bristol-seds/pressure/README.md

## BLE Pressure Sensor

Under development
