bristol-seds/pressure/hardware/Parts.md

# Parts List

---

## Actives

| Part | Description | Farnell # | Quantity Required | Notes
| ---  | --- | --- | --- | ---
|BMP180|Board Mount Pressure Sensors Digital Barometer 12uA, 300-1200hPa|[262-BMP180](http://uk.mouser.com/Search/Refine.aspx?N=1323043&Keyword=262-BMP180)|1|Pressure Sensor
|nRF51822-QFAA-R7|RF System on a Chip - SoC 2.4GHz BT low Energy 256KB Flash 16KB Ram|[949-NRF51822-QFAA-R7](http://uk.mouser.com/Search/Refine.aspx?N=1323043&Keyword=949-NRF51822-QFAA-R7)|1|IC3
|TLV70033DCKT|TEXAS INSTRUMENTS - IC, LDO, 200MA, 3.3V, 5SC70|[1815750](http://uk.farnell.com/webapp/wcs/stores/servlet/Search?st=1815750) [595-TLV70033DCKT](http://uk.mouser.com/Search/Refine.aspx?N=1323043&Keyword=595-TLV70033DCKT)|1|IC4 DCK package = SC70
|MAX1555EZK+T.|MAXIM INTEGRATED PRODUCTS - CHARGER, BATT, LI+, USB/AC, 5SOT23|[1628222](http://uk.farnell.com/webapp/wcs/stores/servlet/Search?st=1628222) [700-MAX1555EZK+T](http://uk.mouser.com/Search/Refine.aspx?N=1323043&Keyword=700-MAX1555EZK+T)|1|IC5
|8Z-16.000MAAJ-T|TXC - XTAL, 16.000MHZ, 18PF, SMD, 2.5X2.0|[1842186](http://uk.farnell.com/webapp/wcs/stores/servlet/Search?st=1842186) [717-8Z-16.000MAAJ-T](http://uk.mouser.com/Search/Refine.aspx?N=1323043&Keyword=717-8Z-16.000MAAJ-T)|1|Y1 Xtal

## Passives

| Part | Description | Farnell # | Quantity Required | Notes
| ---  | --- | --- | --- | ---
|CRG0402F1K0|TE CONNECTIVITY - RESISTOR, FIXED, 1K0, 1%, 0402|[2331474](http://uk.farnell.com/webapp/wcs/stores/servlet/Search?st=2331474)|4|R1 R2 R3 R4 LEDs, pull
|MCFT000004|MULTICOMP - INDUCTOR, 0402, 4.7NH|[1711709](http://uk.farnell.com/webapp/wcs/stores/servlet/Search?st=1711709)|1|L1
|MCFT000007|MULTICOMP - INDUCTOR, 0402, 10NH|[1711712](http://uk.farnell.com/webapp/wcs/stores/servlet/Search?st=1711712)|1|L2
|MCFT000003|MULTICOMP - INDUCTOR, 0402, 3.3NH|[1711708](http://uk.farnell.com/webapp/wcs/stores/servlet/Search?st=1711708)|1|L3
|MLZ1608M100WT|TDK - INDUCTOR, SHIELDED, 10UH, 20%|[2215635](http://uk.farnell.com/webapp/wcs/stores/servlet/Search?st=2215635)|1|L4 10µH
|MCFT000008|MULTICOMP - INDUCTOR, 0402, 15NH|[1711713](http://uk.farnell.com/webapp/wcs/stores/servlet/Search?st=1711713)|1|L5
|GRM155R71A473KA01D|MURATA - CAPACITOR, MLCC, X7R, 0.047UF, 10V, 0402|[2456103](http://uk.farnell.com/webapp/wcs/stores/servlet/Search?st=2456103)|1|C1
|MC0402X104K100CT|MULTICOMP - CAP, MLCC, X5R, 100NF, 10V, 0402|[1759380](http://uk.farnell.com/webapp/wcs/stores/servlet/Search?st=1759380)|3|C2 C10 C13
|MC0402B222J500CT|MULTICOMP - CAP, MLCC, X7R, 2.2NF, 50V, 0402|[2320767](http://uk.farnell.com/webapp/wcs/stores/servlet/Search?st=2320767)|1|C3
|GRM1555C1H1R0CA01D|MURATA - CAP, MLCC, C0G/NP0, 1PF, 50V, 0402|[2218842](http://uk.farnell.com/webapp/wcs/stores/servlet/Search?st=2218842)|1|C4
|GRM1555C1H2R2CA01D|MURATA - CAP, MLCC, C0G, 2.2PF, 50V, 0402|[2434609](http://uk.farnell.com/webapp/wcs/stores/servlet/Search?st=2434609)|1|C5
|GRM1555C1H1R5CA01D|MURATA - CAP, MLCC, C0G/NP0, 1.5PF, 50V, 0402|[1828869](http://uk.farnell.com/webapp/wcs/stores/servlet/Search?st=1828869)|2|C6 C7
|MC0402X105K6R3CT|MULTICOMP - CAP, MLCC, X5R, 1UF, 6.3V, 0402|[1759375](http://uk.farnell.com/webapp/wcs/stores/servlet/Search?st=1759375)|1|C8
|GRM155R60J475ME87D|MURATA - CAP, MLCC, X5R, 4.7UF, 6.3V, 0402|[2362092](http://uk.farnell.com/webapp/wcs/stores/servlet/Search?st=2362092)|1|C9
|MC0402N120J500CT|MULTICOMP - CAP, MLCC, C0G/NP0, 12PF, 50V, 0402|[1758943](http://uk.farnell.com/webapp/wcs/stores/servlet/Search?st=1758943)|2|C11 C12
|MC0603X105M6R3CT|MULTICOMP - CAP, MLCC, X5R, 1UF, 6.3V, 0603|[2309013](http://uk.farnell.com/webapp/wcs/stores/servlet/Search?st=2309013)|3|C14 C15 C16

## Misc

| Part | Description | Farnell # | Quantity Required | Notes
| ---  | --- | --- | --- | ---
|20021121-00010C4LF|FCI - CONNECTOR, HEADER, SMT, R/A, 1.27MM, 10P|[1865279](http://uk.farnell.com/webapp/wcs/stores/servlet/Search?st=1865279) [649-202112100010C4LF](http://uk.mouser.com/Search/Refine.aspx?N=1323043&Keyword=649-202112100010C4LF)|1|JTAG1
|USB3065-30-00-A|GLOBAL CONNECTOR TECHNOLOGY - CONN, USB 2.0 MICRO B, RCPT, 5POS, SMT|[2443111](http://uk.farnell.com/webapp/wcs/stores/servlet/Search?st=2443111)|1|X1 µUSB
