bristol-seds/pressure/hardware/pressure.brd

## EAGLE design hardware/pressure.brd (2015-03-13)

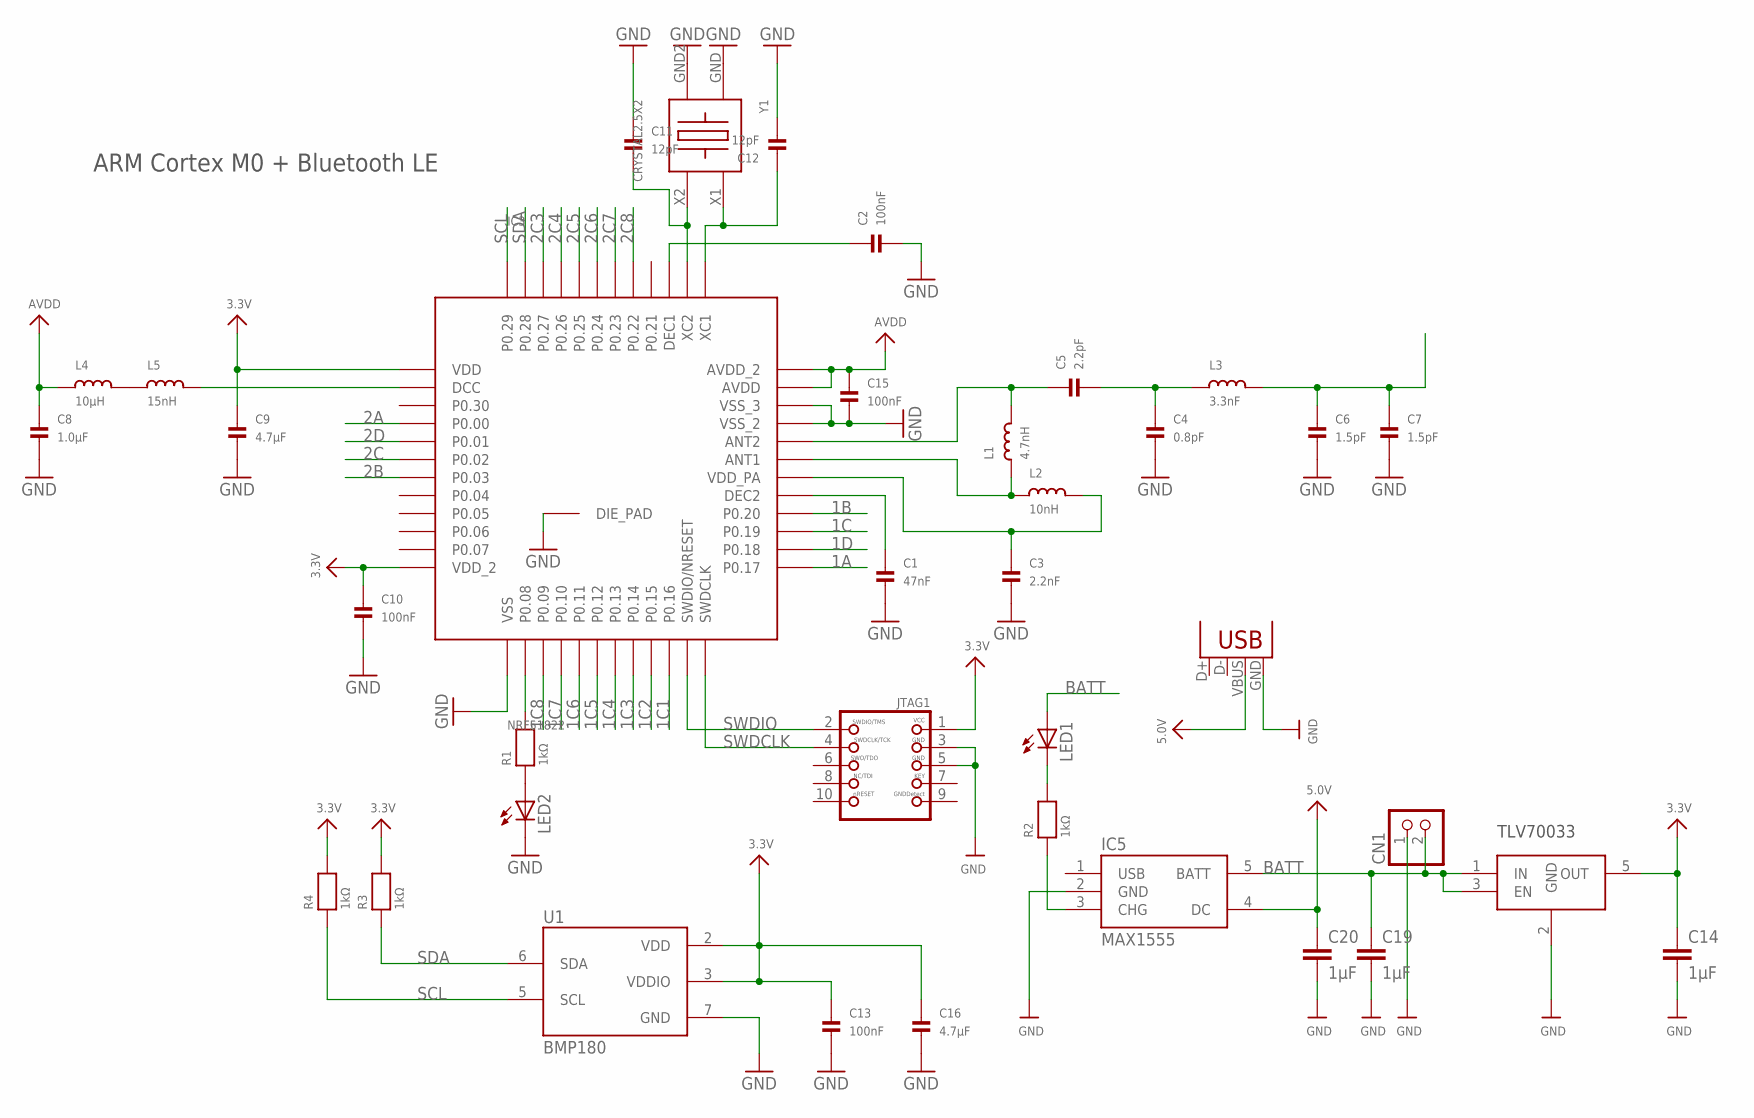
[picture p1: schematic pressure.sch]

Parts:
C1: 47nF; _0402
C2, C10, C13, C15: 100nF; _0402
C3: 2.2nF; _0402
C4: 0.8pF; _0402
C5: 2.2pF; _0402
C6, C7: 1.5pF; _0402
C8: 1.0µF; _0402
C9, C16: 4.7µF; _0402
C11, C12: 12pF; _0402
C14, C19, C20: 1µF; C0603K
CN1: JST_2PIN; JSTPH2
IC3: NRF51822; QFN48
IC4: TLV70033DCK; SC70-5L
IC5: MAX1555; SOT23-5
JTAG1: JTAG-CORTEXM3SMT; 2X05_1.27MM_SMT
L1: 4.7nH; _0402
L2: 10nH; _0402
L3: 3.3nF; _0402
L4: 10µH; _0402
L5: 15nH; _0402
LED1, LED2: LEDCHIPLED_0603; CHIPLED_0603
R1, R2, R3, R4: 1kΩ; _0402
U1: BMP180
X1: USB-MICROB
Y1: CRYSTAL2.5X2; 2.5X2MM

Connections:
1A: IC3.25 (P0.17)
1B: IC3.28 (P0.20)
1C: IC3.27 (P0.19)
1C1: IC3.22 (P0.16)
1C2: IC3.21 (P0.15)
1C3: IC3.20 (P0.14)
1C4: IC3.19 (P0.13)
1C5: IC3.18 (P0.12)
1C6: IC3.17 (P0.11)
1C7: IC3.16 (P0.10)
1C8: IC3.15 (P0.09)
1D: IC3.26 (P0.18)
2A: IC3.4 (P0.00)
2B: IC3.7 (P0.03)
2C: IC3.6 (P0.02)
2C3: IC3.46 (P0.27)
2C4: IC3.45 (P0.26)
2C5: IC3.44 (P0.25)
2C6: IC3.43 (P0.24)
2C7: IC3.42 (P0.23)
2C8: IC3.41 (P0.22)
2D: IC3.5 (P0.01)
3.3V: C9.1, C10.1, C13.1, C14.1, C16.1, IC3.1 (VDD), IC3.12 (VDD_2), IC4.5 (OUT), JTAG1.1, R3.2, R4.2, U1.2 (VDD), U1.3 (VDDIO)
5.0V: C20.1, IC5.4 (DC), X1.VBUS
ANT: C6.1, C7.1, L3.2
ANT1: IC3.31 (ANT1), L1.1, L2.1
ANT2: C5.1, IC3.32 (ANT2), L1.2
AVDD: C8.1, C15.1, IC3.35 (AVDD), IC3.36 (AVDD_2), L4.1
BATT: C19.1, CN1.2, IC4.1 (IN), IC4.3 (EN), IC5.5 (BATT), LED1.A
CHG: IC5.3 (CHG), R2.1
DCC: IC3.2 (DCC), L5.2
DEC1: C2.1, IC3.39 (DEC1)
DEC2: C1.1, IC3.29 (DEC2)
GND: C1.2, C2.2, C3.2, C4.2, C6.2, C7.2, C8.2, C9.2, C10.2, C11.1, C12.2, C13.2, C14.2, C15.2, C16.2, C19.2, C20.2, CN1.1, IC3.13 (VSS), IC3.33 (VSS_2), IC3.34 (VSS_3), IC3.GND (DIE_PAD), IC4.2 (GND), IC5.2 (GND), JTAG1.3, JTAG1.5, LED2.C, U1.7 (GND), X1.GND, Y1.GND, Y1.GND2
LED: LED1.C, R2.2
unnamed: L4.2, L5.1
unnamed: IC3.14 (P0.08), R1.2
unnamed: LED2.A, R1.1
SCL: IC3.48 (P0.29), R4.1, U1.5 (SCL)
SDA: IC3.47 (P0.28), R3.1, U1.6 (SDA)
SWDCLK: IC3.24 (SWDCLK), JTAG1.4
SWDIO: IC3.23 (SWDIO/NRESET), JTAG1.2
UNBAL: C4.1, C5.2, L3.1
VDD_PA: C3.1, IC3.30 (VDD_PA), L2.2
X1: C12.1, IC3.37 (XC1), Y1.X1
X2: C11.2, IC3.38 (XC2), Y1.X2

Notes on the sheet:
ARM Cortex M0 + Bluetooth LE
TLV70033

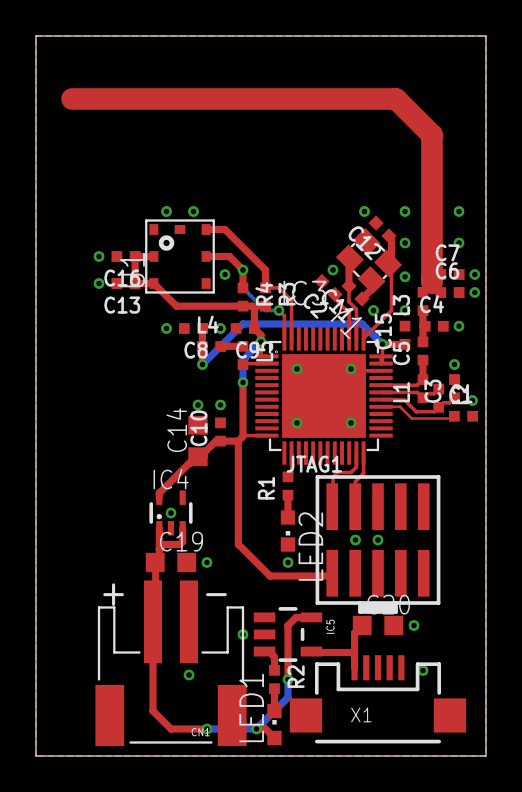
[picture p2: board pressure.brd from above]

Board: 2 copper layers, 25.0 x 40.0 mm, 37 parts (0 on the bottom side), 24 nets.
