bristol-seds/pressure/(commit log)

2015-03-13 Added partslist
    [pressure.brd, pressure.sch]
2015-03-27 Test Hrs app, reading from barometer correctly
    [bmp180.c, bmp180.h, led.c, main.c]
